MexRoboTics/OttoDIY-MXR/CAD/Foot_Left.STL

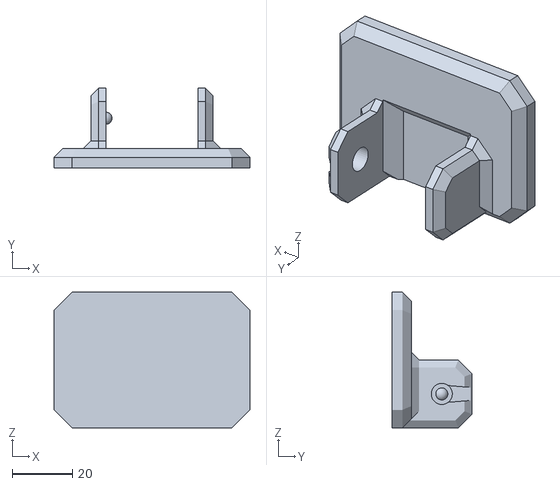
[picture p9: CAD file, 2018-01-29]
CAD/Foot_Left.STL
65.0 x 26.5 x 45.0
