MexRoboTics/OttoDIY-MXR/CAD/Body.STL

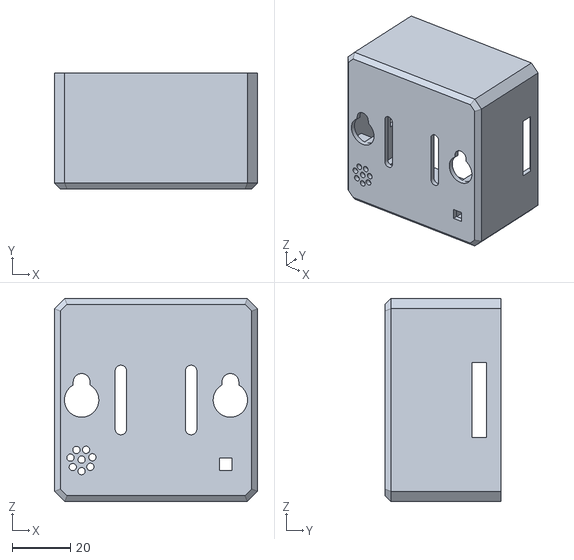
[picture p10: CAD file, 2018-01-29]
CAD/Body.STL
70.0 x 40.0 x 70.0
