MexRoboTics/OttoDIY-MXR/CAD/Leg.STL

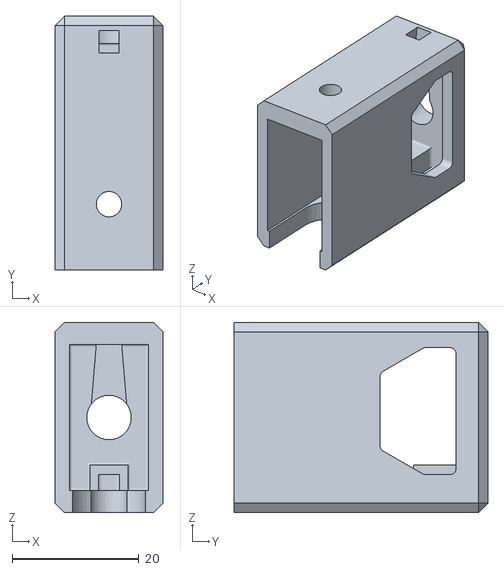
[picture p11: CAD file, 2018-01-29]
CAD/Leg.STL
17.0 x 40.0 x 30.0
