MexRoboTics/OttoDIY-MXR/CAD/Head.STL

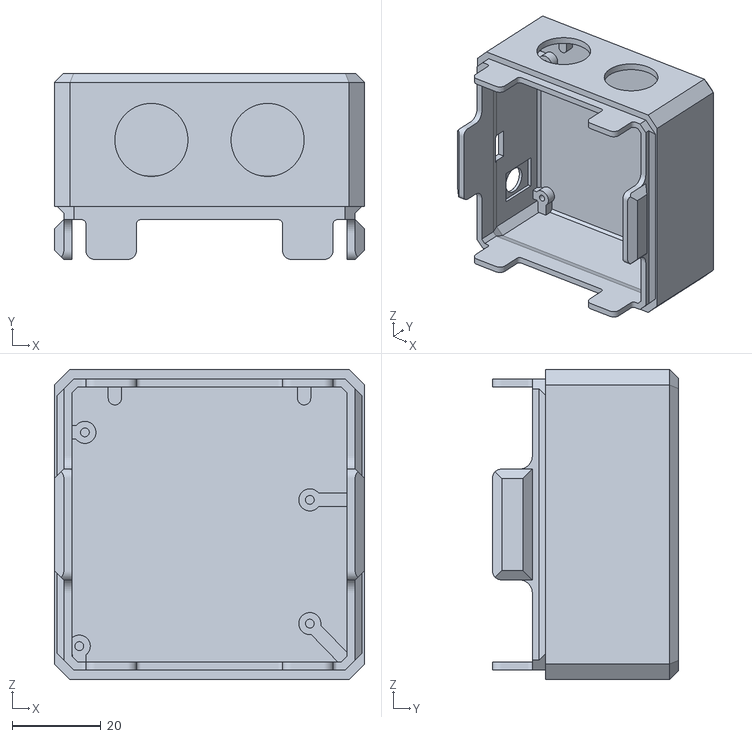
[picture p12: CAD file, 2018-01-29]
CAD/Head.STL
70.0 x 42.0 x 70.0
