MexRoboTics/OttoDIY-MXR/(list of files, cad)

Other CAD files:
CAD/Foot_Right.STL
