MexRoboTics/OttoDIY-MXR/Images/Otto_Assembly1.PNG

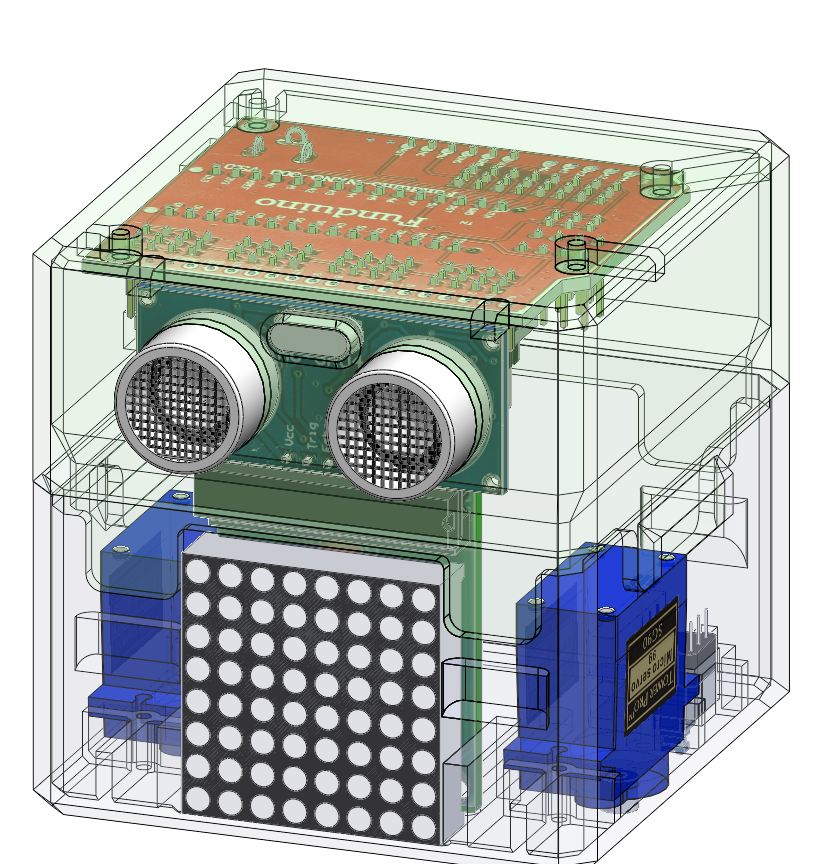
Images/Otto_Assembly1.PNG
