MexRoboTics/OttoDIY-MXR/Images/Otto_Assembly2.PNG

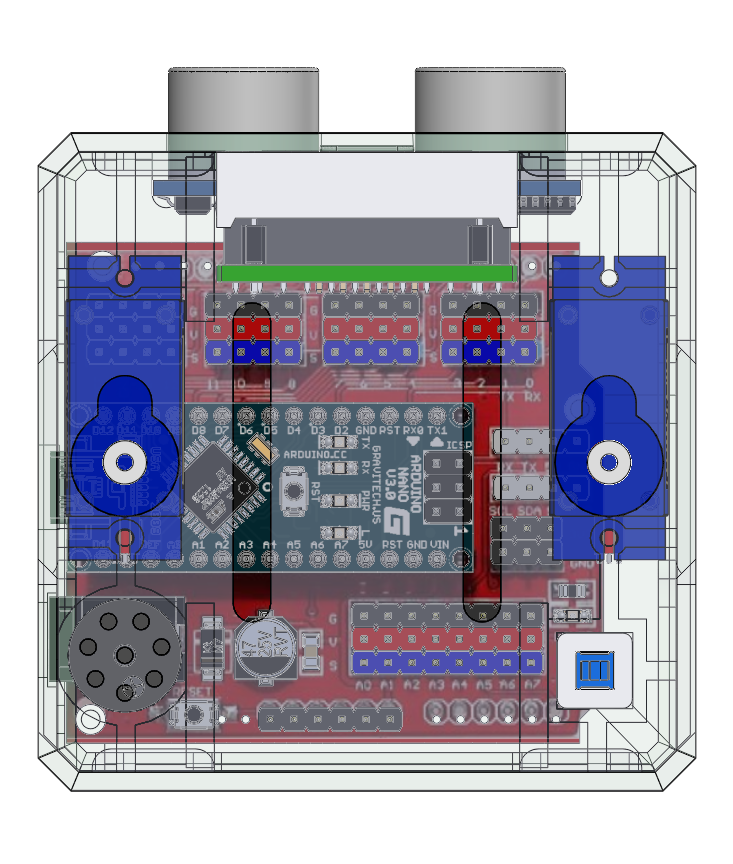
Images/Otto_Assembly2.PNG
