MexRoboTics/OttoDIY-MXR/Images/Otto_Assembly3.PNG

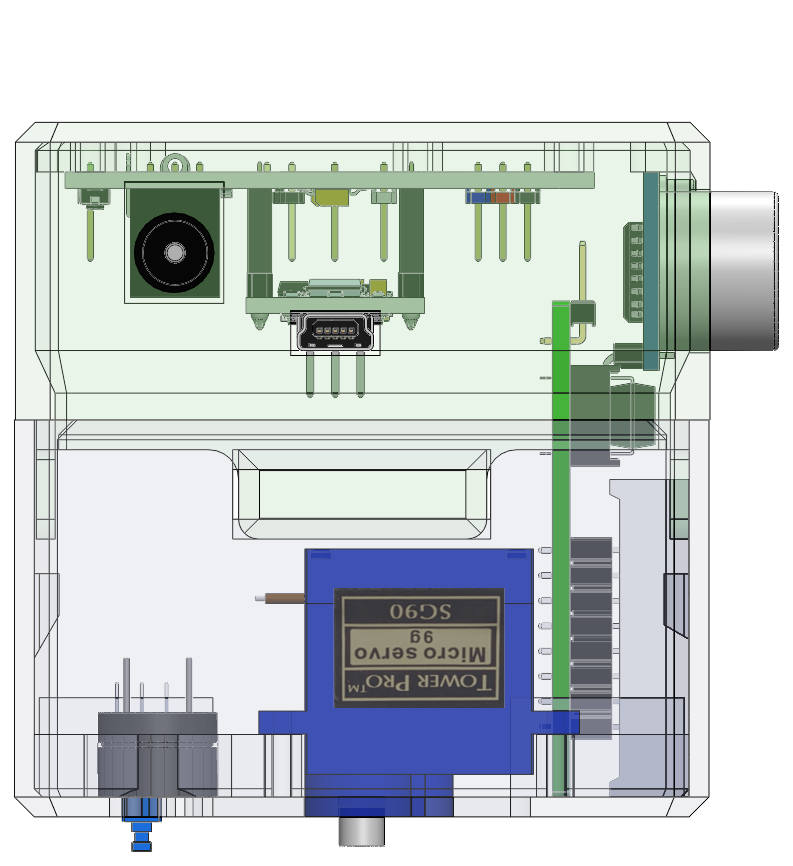
Images/Otto_Assembly3.PNG
