MexRoboTics/OttoDIY-MXR/OttoDIY-MXR_InstructionsManual_V01.pdf

# DIY-MXR

# INSTRUCTION MANUAL

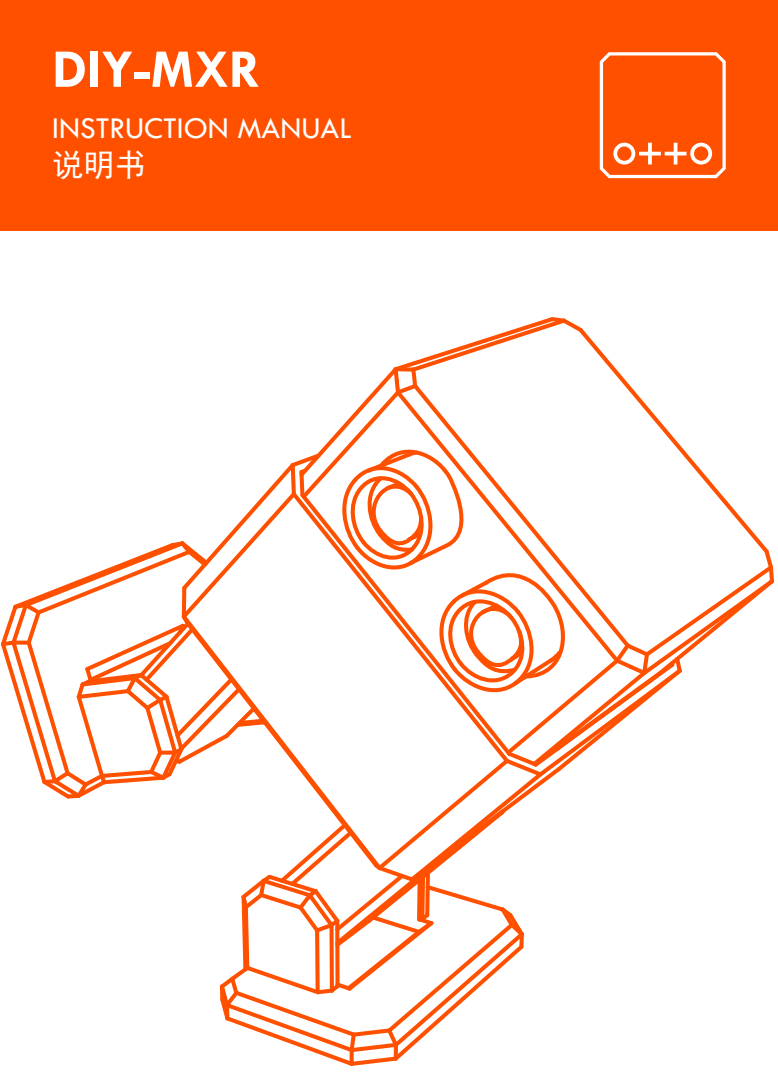
[picture p16: page 1]
说明书

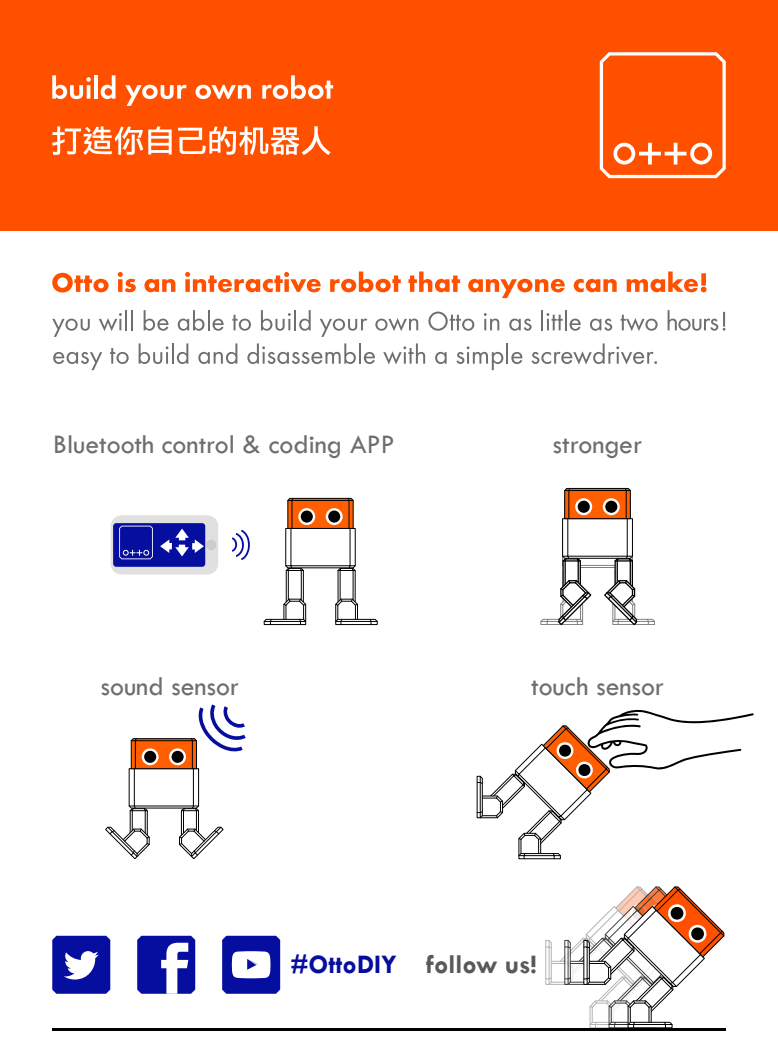
[picture p17: page 2]
sound sensor; touch sensor; stronger

Bluetooth control & coding APP

#OttoDIY follow us!

部分

# PARTS

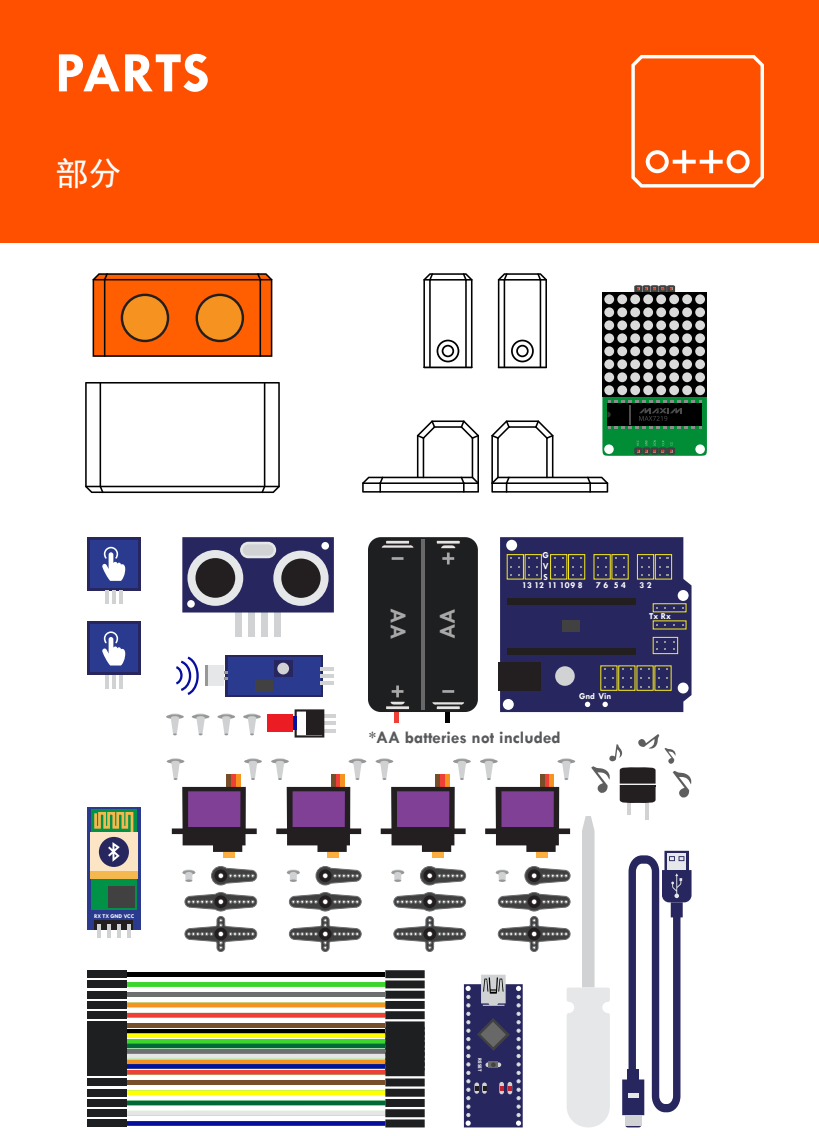
[picture p18: page 3]
Gnd Vin

*AA batteries not included RESET

RX TX GND VCC

a

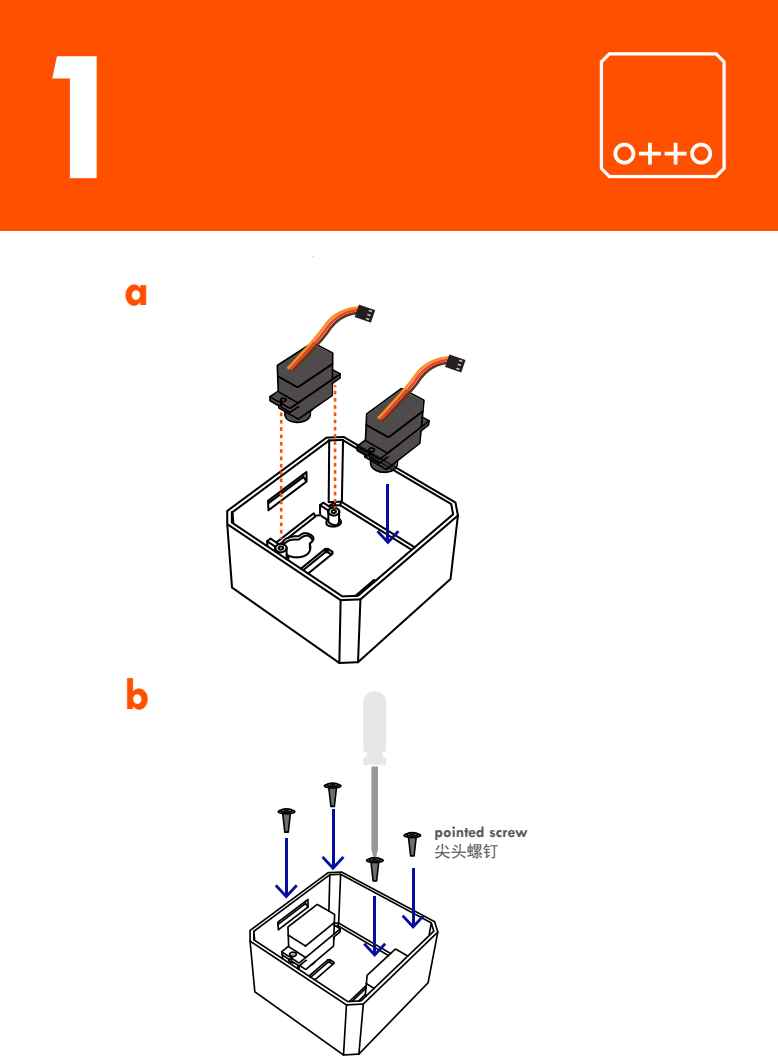
[picture p19: page 4]
pointed screw 尖头螺钉

a

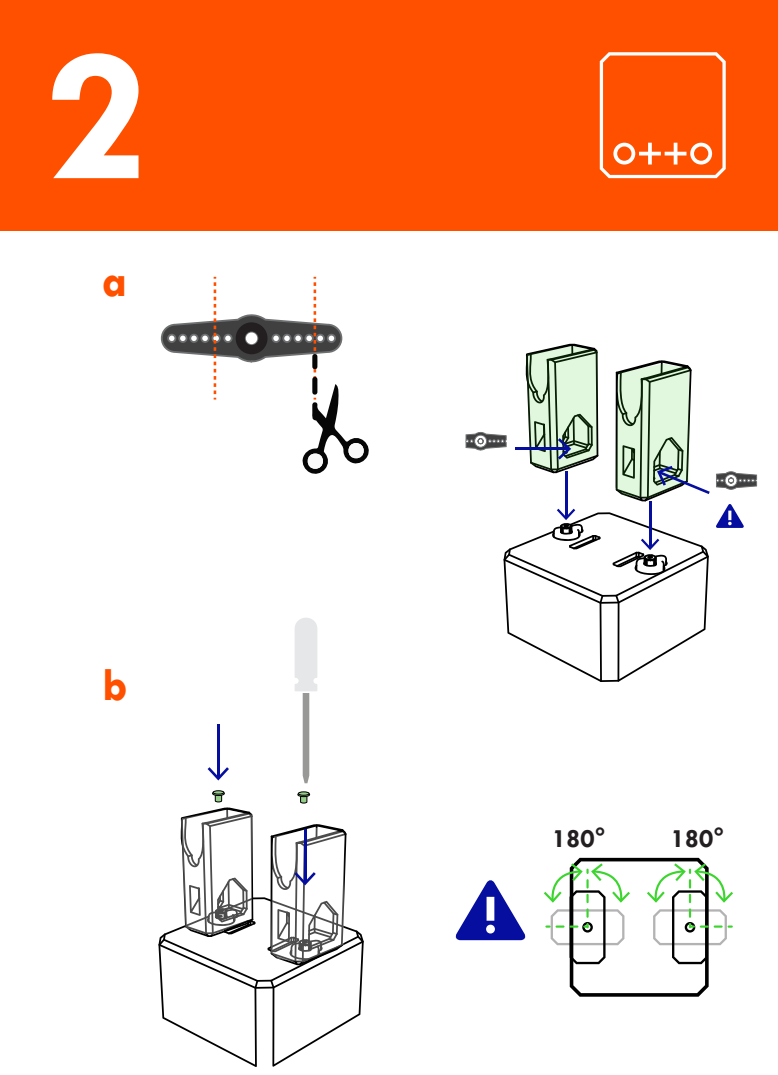
[picture p20: page 5]

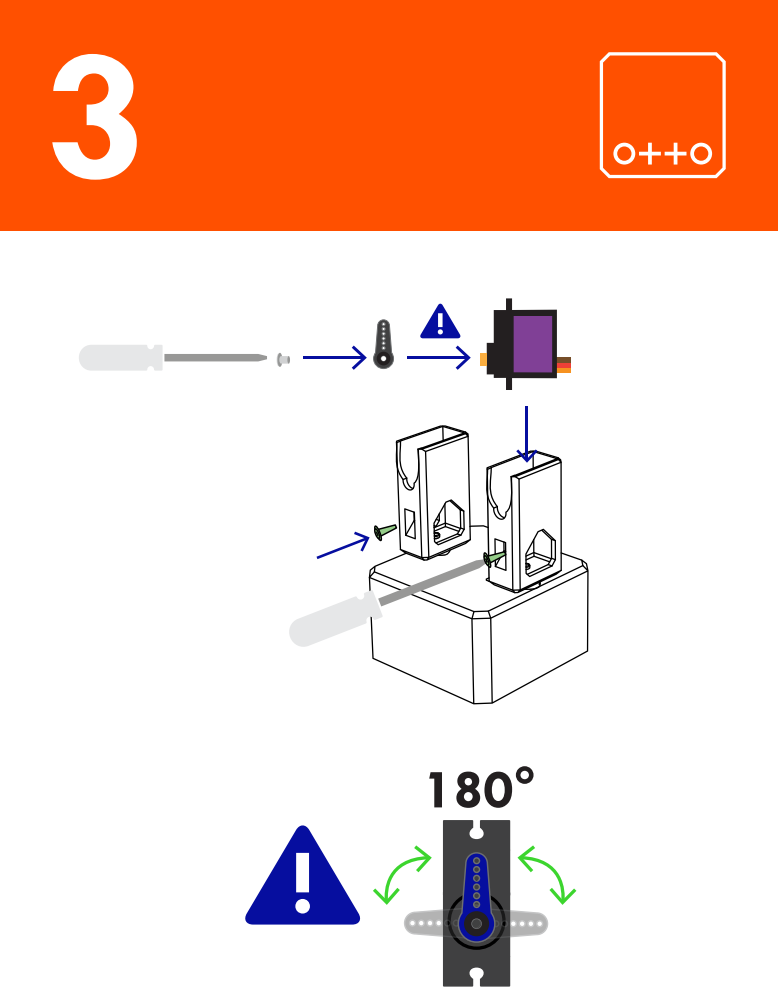
[picture p21: page 6]

ab

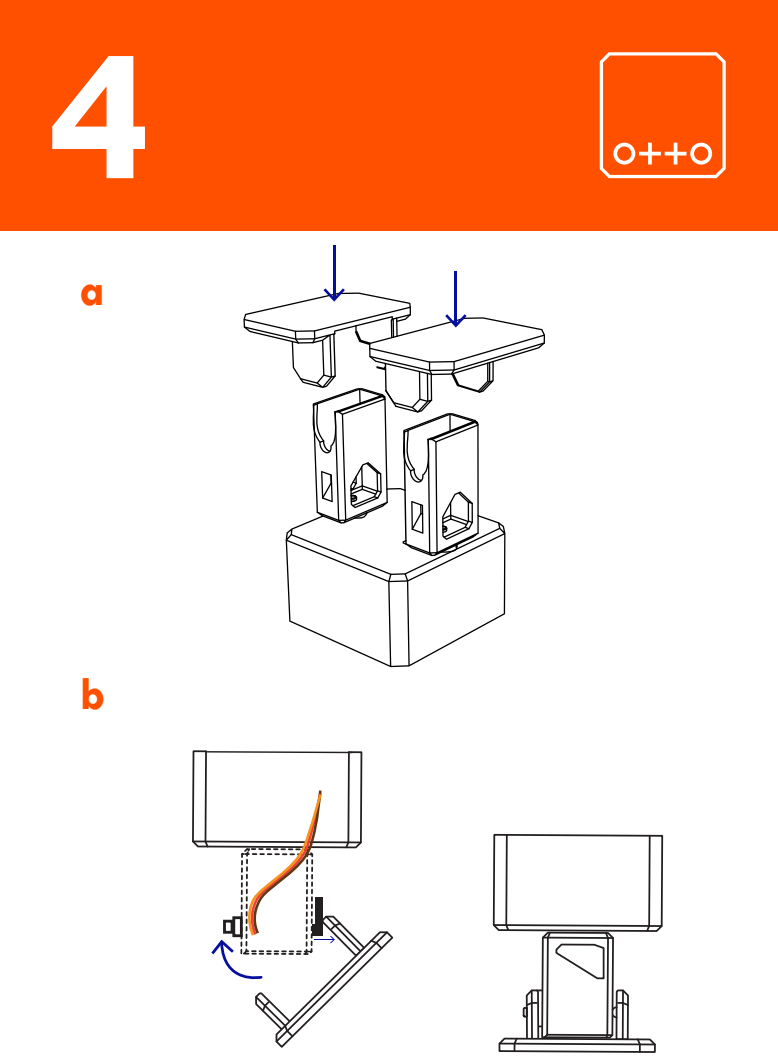
[picture p22: page 7]

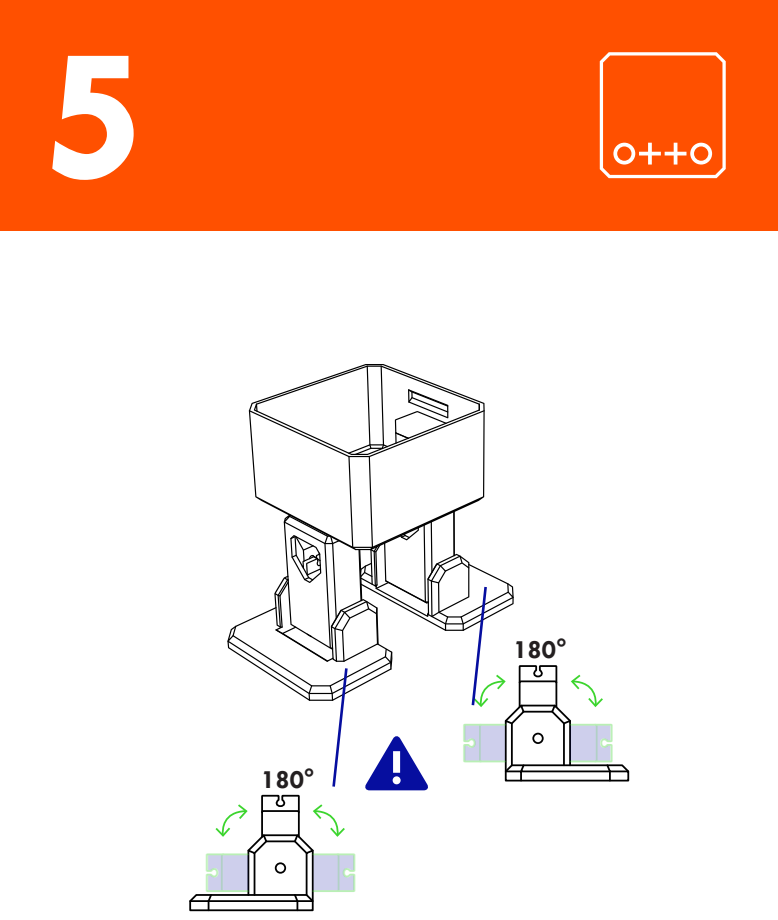
[picture p23: page 8]

ab

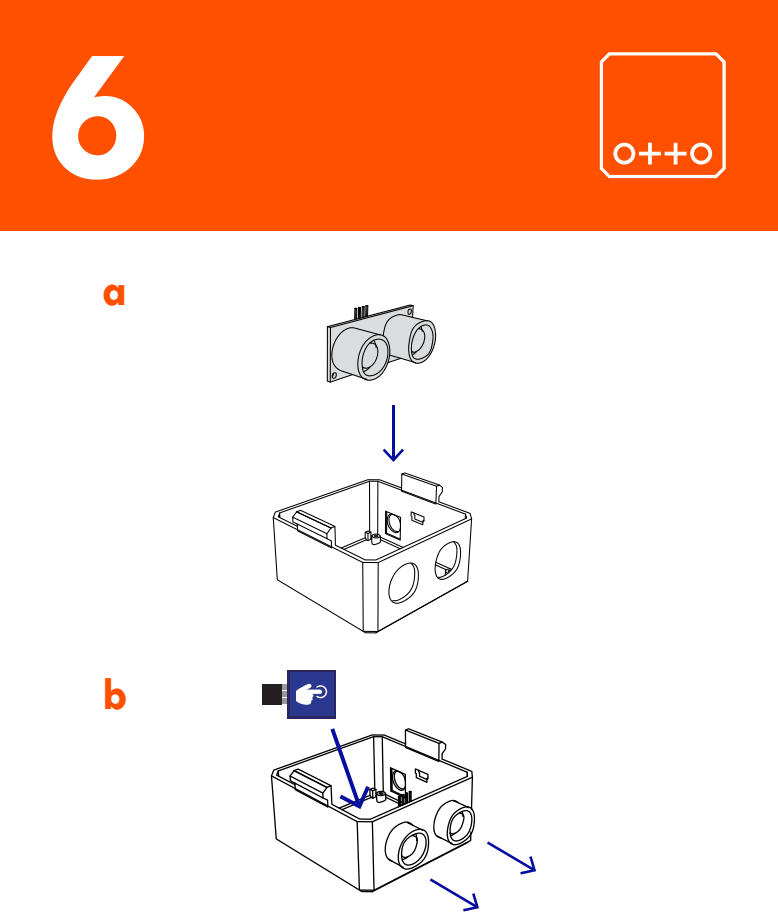
[picture p24: page 9]

ab

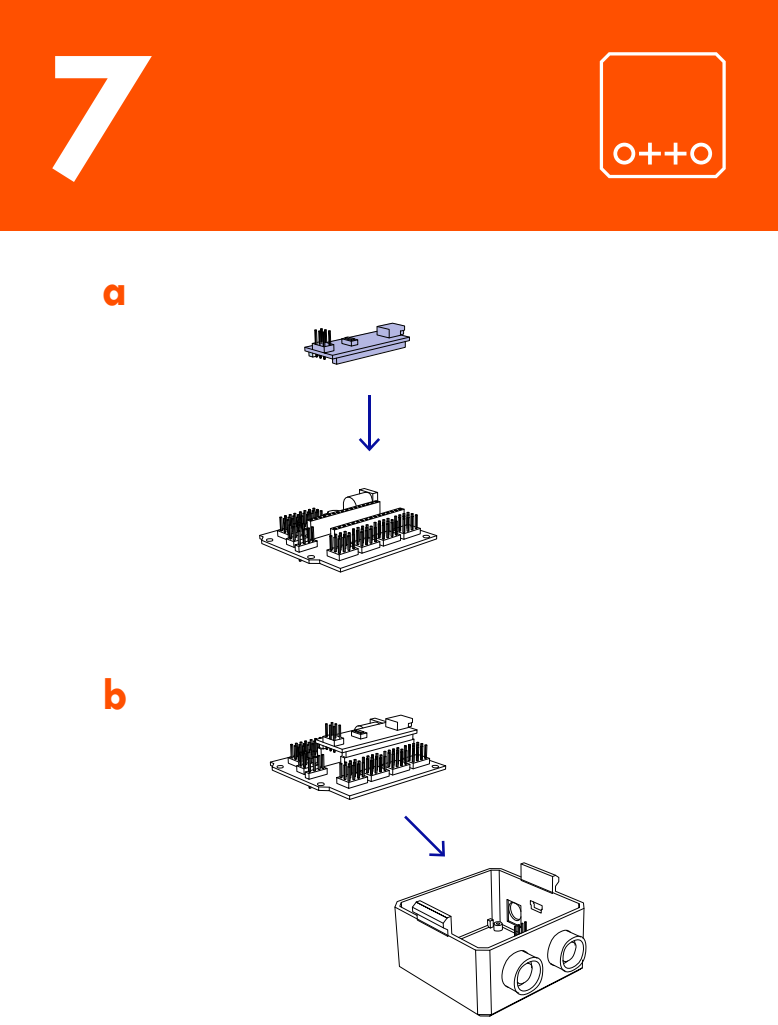
[picture p25: page 10]

ab

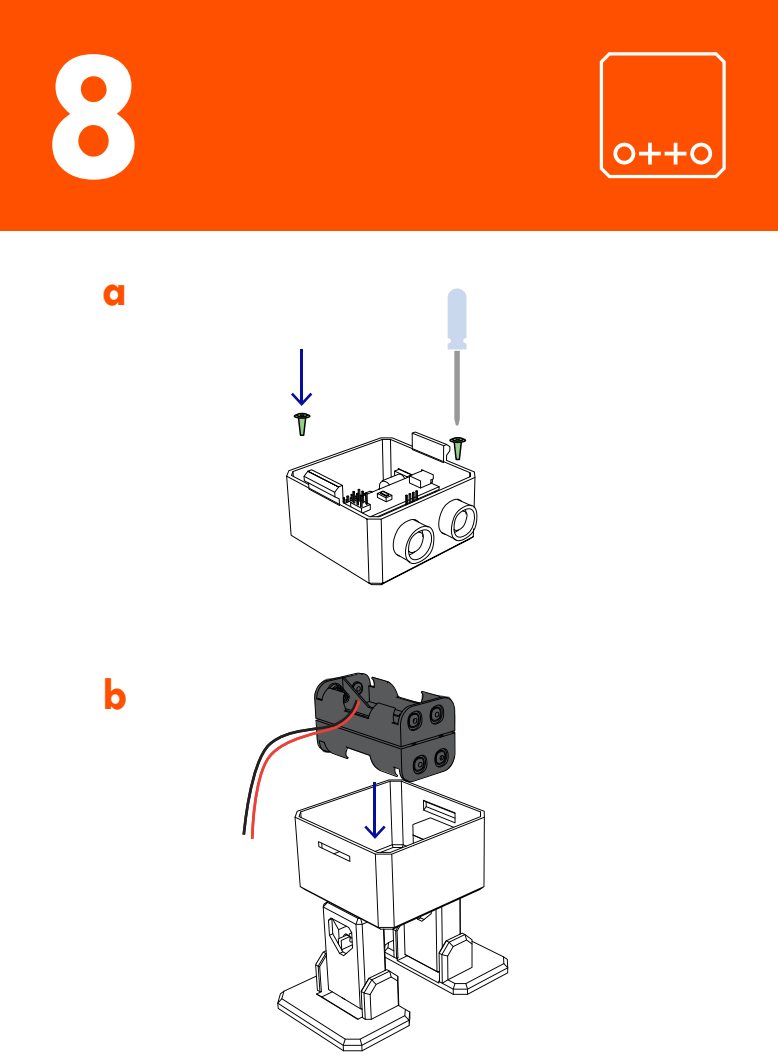
[picture p26: page 11]

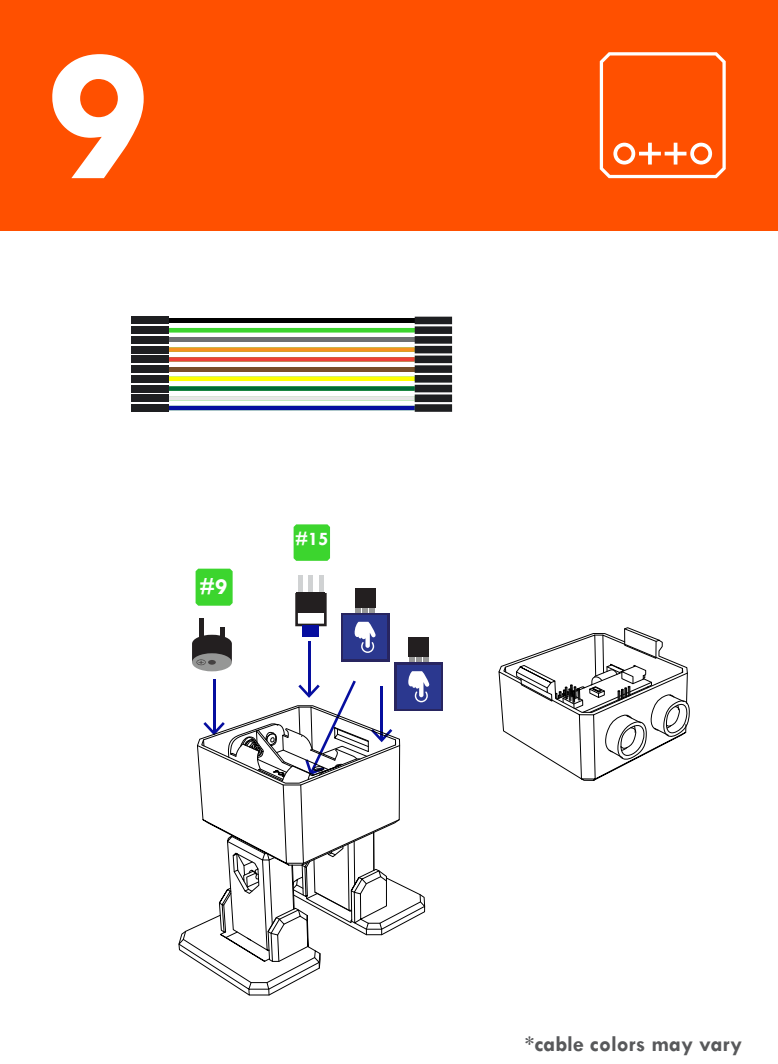
[picture p27: page 12]

*cable colors may vary

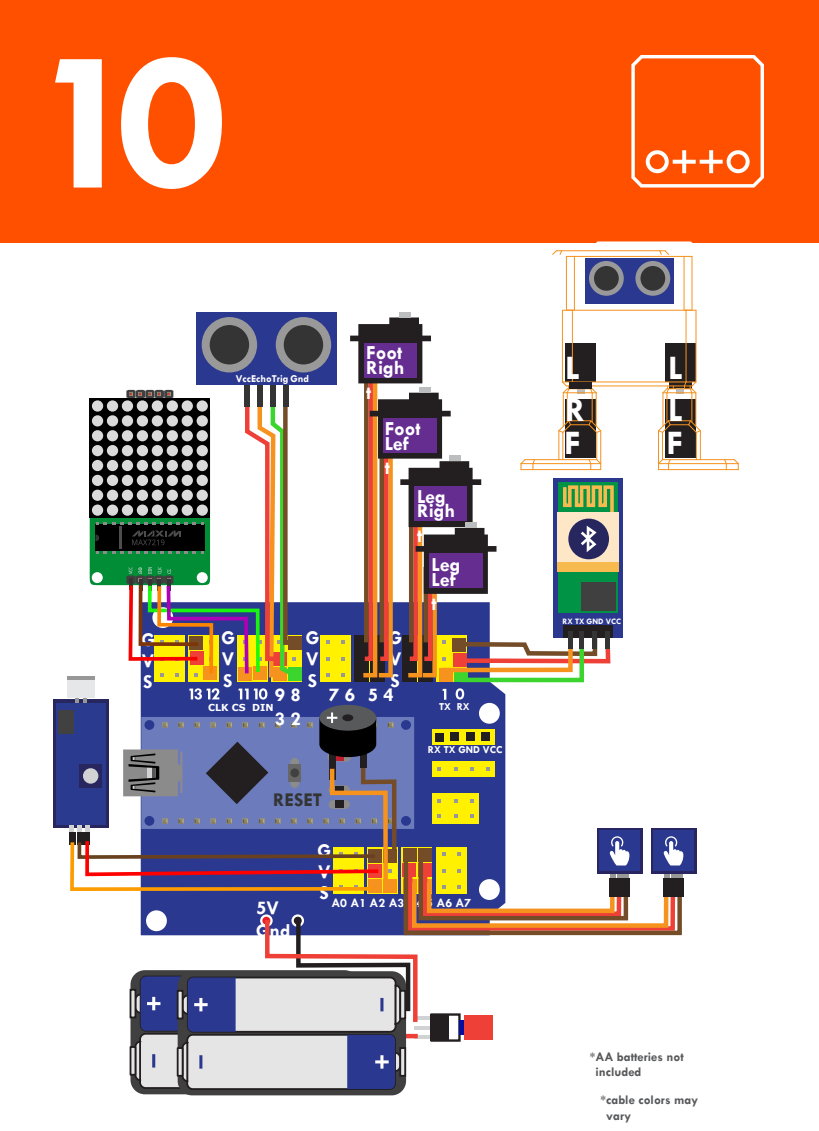
[picture p28: page 13]
RESET; 5V Gnd; Foot Righ t; Leg Lef t; Leg Righ t; Foot Lef t; VccEchoTrig Gnd; CLK CS DIN

RX TX GND VCC

*AA batteries not
included

*cable colors may
vary

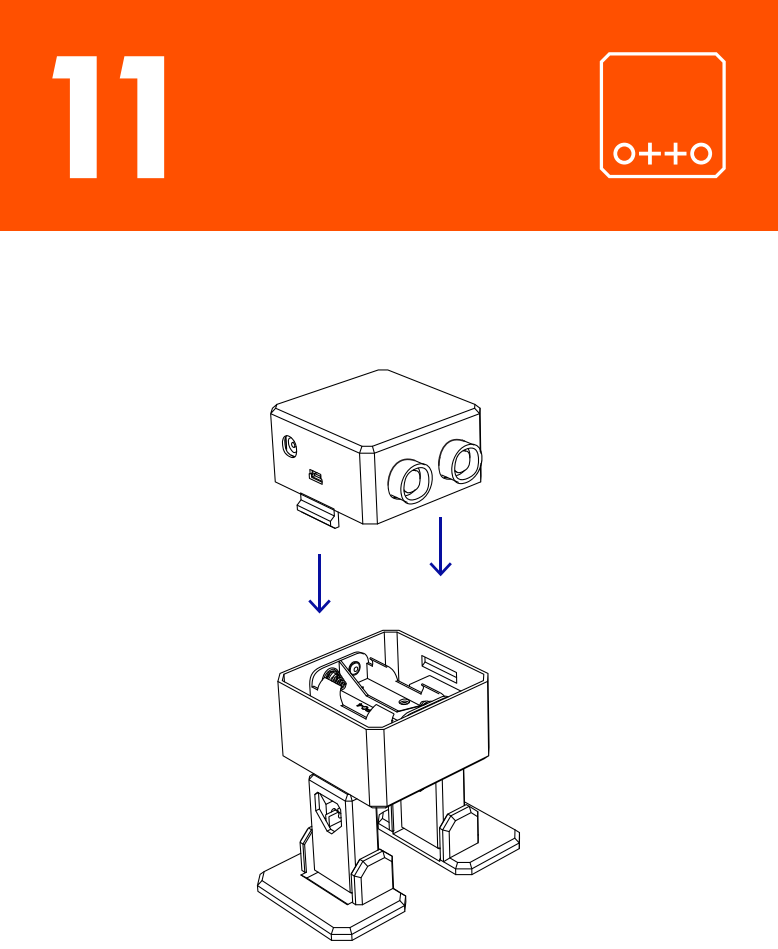
[picture p29: page 14]

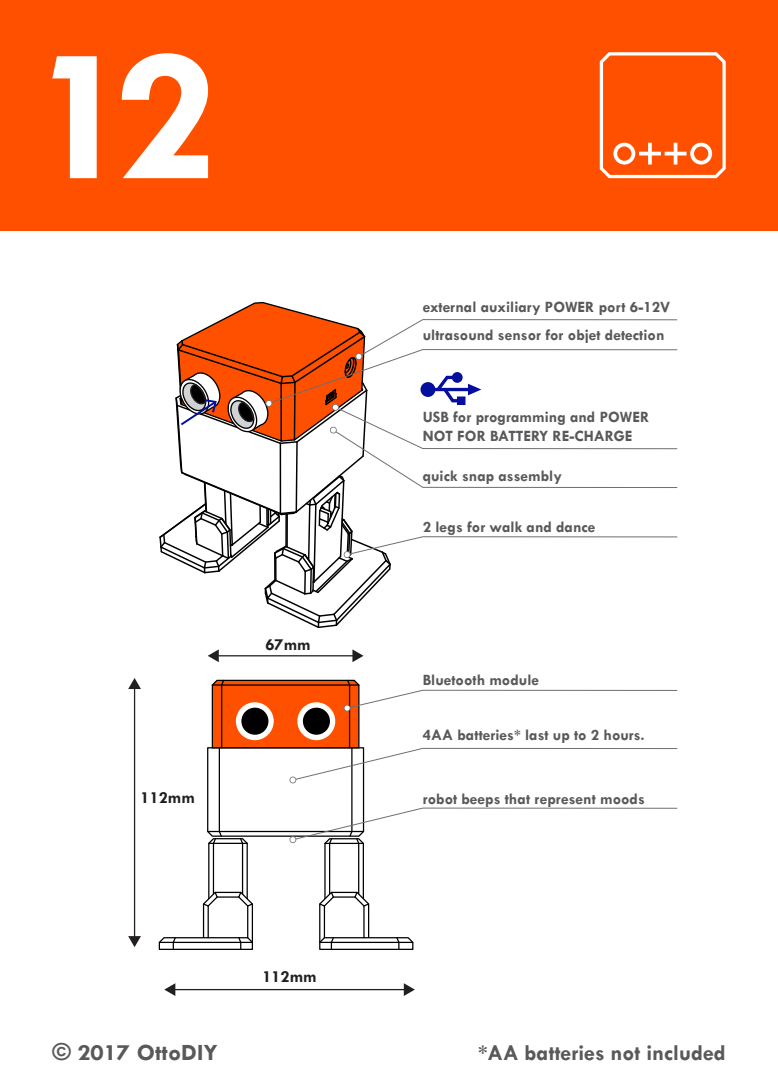
[picture p30: page 15]
Bluetooth module; © 2017 OttoDIY; *AA batteries not included

external auxiliary POWER port 6-12V
ultrasound sensor for objet detection

USB for programming and POWER
NOT FOR BATTERY RE-CHARGE

quick snap assembly

2 legs for walk and dance

4AA batteries* last up to 2 hours.

robot beeps that represent moods

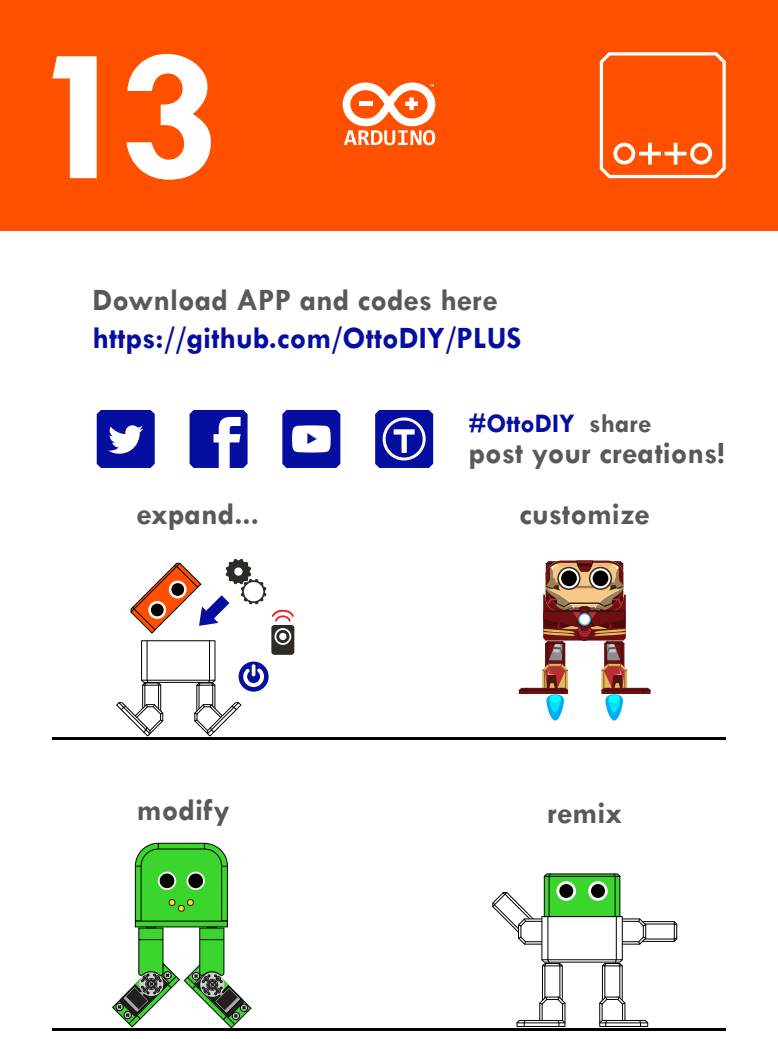
[picture p31: page 16]
remix; expand...; modify

Download APP and codes here
https://github.com/OttoDIY/PLUS

#OttoDIY share
post your creations!
customize


# ottodiy.com
